GridTICs/gateway-sipia-ciaa/Utilidades/Poncho_EDUCIAA/PonchoKiCad_v1.0/Vistas3D/PonchoGatewayFinal.jpg

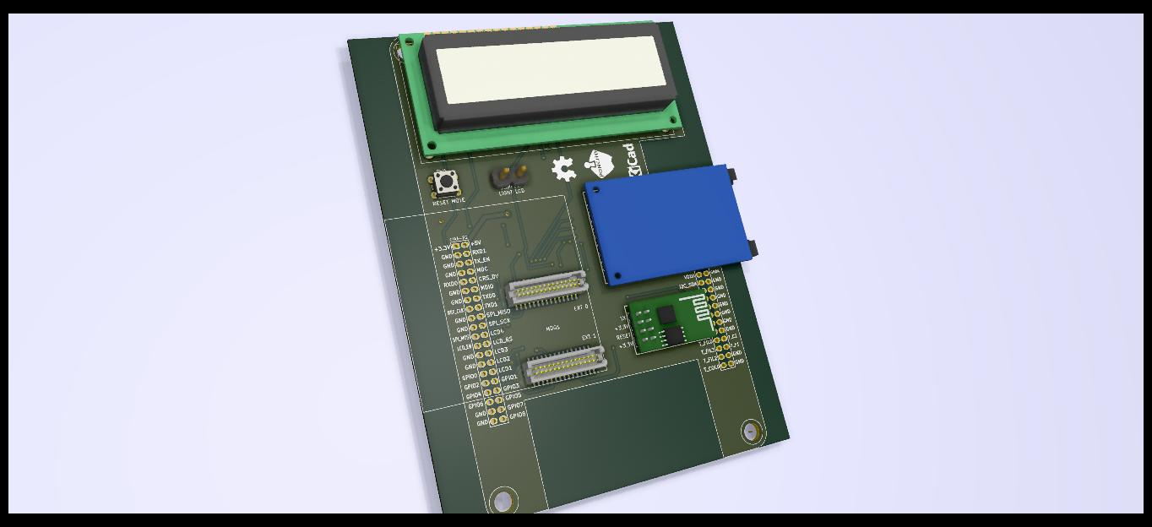
Utilidades/Poncho_EDUCIAA/PonchoKiCad_v1.0/Vistas3D/PonchoGatewayFinal.jpg
