GridTICs/gateway-sipia-ciaa/README.md

# Proyecto Final UTN-FRM - Ingeniería Electrónica

_El proyecto se basa en la creación de un gateway que enlaza una red de sensores con un servidor de internet. El README está en su versión beta._ 🚀

_Estas instrucciones te permitirán obtener una copia del proyecto en funcionamiento en tu CIAA para propósitos de desarrollo y pruebas._

*Todo se ha realizado en base al proyecto EDU-CIAA.*

*Se puede encontrar información correspondiente en su página:*

http://www.proyecto-ciaa.com.ar

### Pre-requisitos 📋

> ```
> Tener instalado el "Embedded IDE", GUI de programación de la EDU-CIAA, creada por Martin Ribelotta - El proyecto está creado en dicha aplicación corriendo en Windows 10 x64.
> ```
>

*Dicho software se puede obtener del siguiente link:*

https://github.com/martinribelotta/embedded-ide-builder/releases/tag/v0.6

*En el mismo ya se encuentran las herramientas necesarias para grabar la EDU-CIAA (NXP en mi caso).*

### Instalación 🔧

_Una serie de ejemplos paso a paso que te dice lo que debes ejecutar para tener un entorno de desarrollo ejecutandose_

_Dí cómo será ese paso_

```
Da un ejemplo
```

_Y repite_

```
hasta finalizar
```

_Finaliza con un ejemplo de cómo obtener datos del sistema o como usarlos para una pequeña demo_-

## Ejecutando las pruebas ⚙️

_Explica como ejecutar las pruebas automatizadas para este sistema_

### Analice las pruebas end-to-end 🔩

_Explica que verifican estas pruebas y por qué_

```
Da un ejemplo
```

### Y las pruebas de estilo de codificación ⌨️

_Explica que verifican estas pruebas y por qué_

```
Da un ejemplo
```

## Deployment 📦

_Agrega notas adicionales sobre como hacer deploy_

## Construido con 🛠️

_[CIAA Embedded IDE](https://github.com/martinribelotta/embedded-ide-builder/releases/tag/v0.6) - El IDE de programación utilizado.

## Contribuyendo 🖇️

Por el momento el proyecto es de carácter privado, pero será abierto cuando la versión beta 1.0 esté finalizada.

## Wiki 📖

Puedes encontrar mucho más de cómo utilizar este proyecto en nuestra [Wiki](https://github.com/tu/proyecto/wiki)

## Autores ✒️

_Menciona a todos aquellos que ayudaron a levantar el proyecto desde sus inicios_

* **Lucas Escribano** - [harrylae](https://github.com/harrylae)
* **Rodrigo Gonzalez** 

## Expresiones de Gratitud 🎁
