GridTICs/gateway-sipia-ciaa/Utilidades/PIN_Outs_Datasheets/ESP8266_Datasheet/ELEC-ESP01S-000.jpg

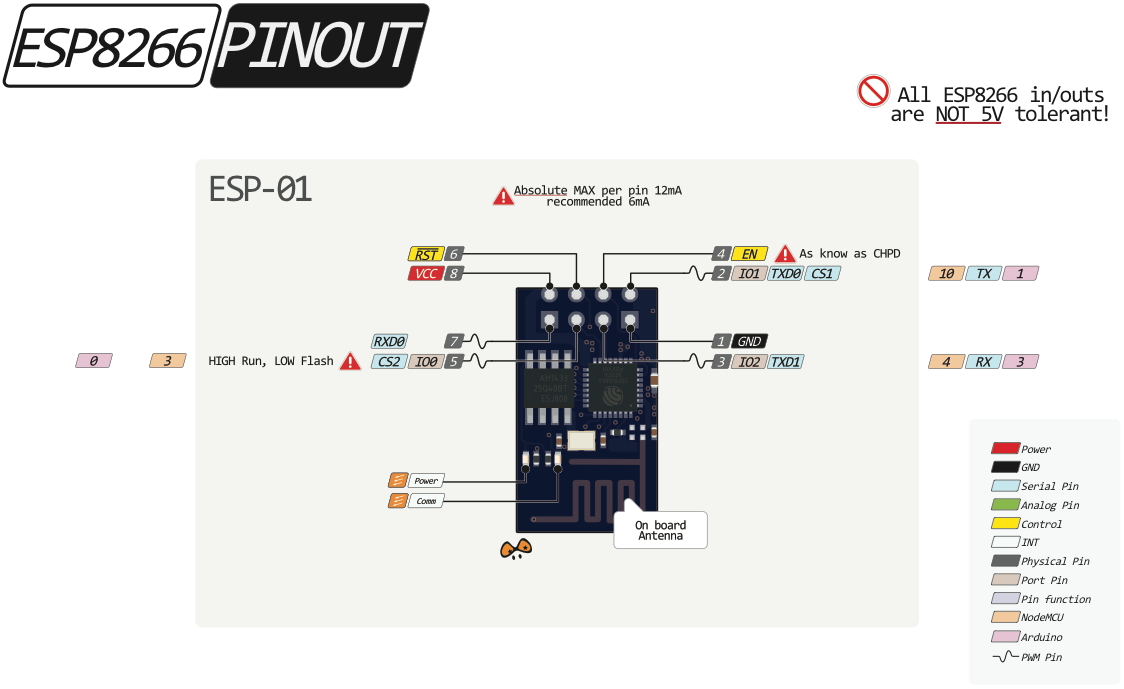
Utilidades/PIN_Outs_Datasheets/ESP8266_Datasheet/ELEC-ESP01S-000.jpg
