GridTICs/gateway-sipia-ciaa/Utilidades/PIN_Outs_Datasheets/SD_Pinout/LC-Studio-SD-Card-Pin-Outs.png

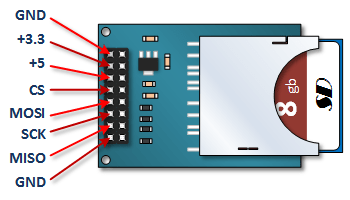
Utilidades/PIN_Outs_Datasheets/SD_Pinout/LC-Studio-SD-Card-Pin-Outs.png
