GridTICs/gateway-sipia-ciaa/Utilidades/Zadig/thumbnail_imagen (1).png

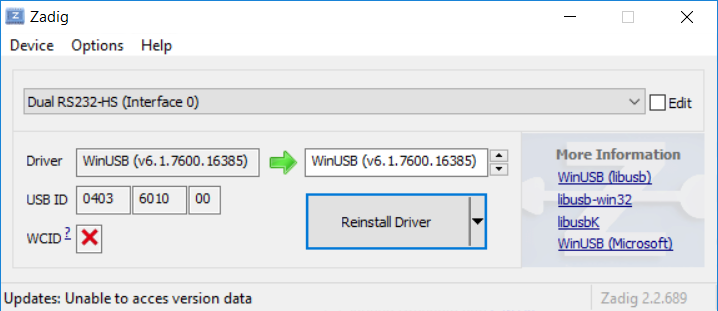
Utilidades/Zadig/thumbnail_imagen (1).png
