GridTICs/gateway-sipia-ciaa/Utilidades/Poncho_EDUCIAA/PonchoKiCad_v1.0/PonchoGateway/3D_Vistas/TFM-115-02-S-D-LC.stp

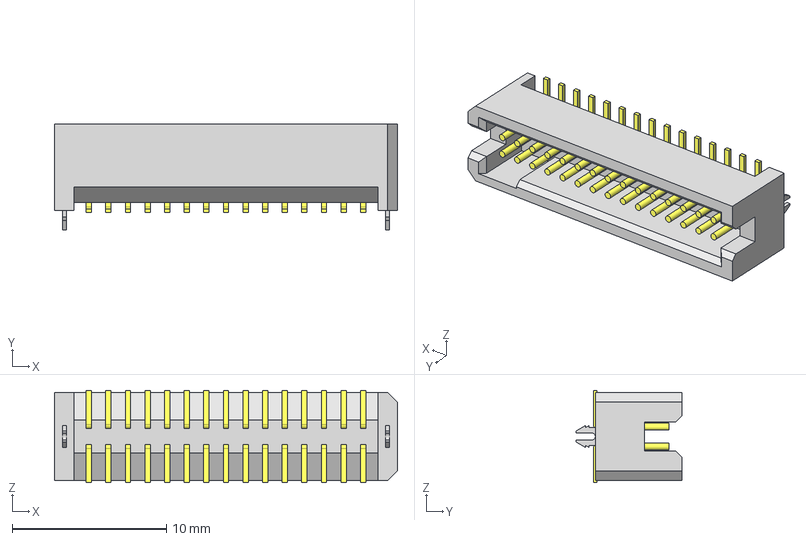
[picture p45: CAD file, 2019-07-15]
Utilidades/Poncho_EDUCIAA/PonchoKiCad_v1.0/PonchoGateway/3D_Vistas/TFM-115-02-S-D-LC.stp
22.2 x 6.86 x 5.97 mm
_TFM-115-02-L-D-LC_terminal
_TFM-115-02-L-D_pins
