GridTICs/gateway-sipia-ciaa/Utilidades/Poncho_EDUCIAA/PonchoKiCad_v1.0/PonchoGateway/3D_Vistas/SD Card Module Arduino.STEP

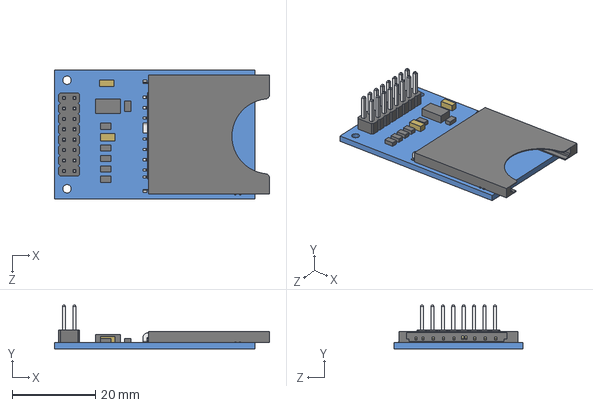
[picture p46: CAD file, 2019-06-25]
Utilidades/Poncho_EDUCIAA/PonchoKiCad_v1.0/PonchoGateway/3D_Vistas/SD Card Module Arduino.STEP
51.5 x 10.5 x 31.0 mm
SD Card Module-part
SD socket
