GridTICs/gateway-sipia-ciaa/Utilidades/Poncho_EDUCIAA/PonchoKiCad_v1.0/PonchoGateway/3D_Vistas/2.54 mm DUPONT MALE PIN HEADER, CONFIGURABLE, 1X2.STEP

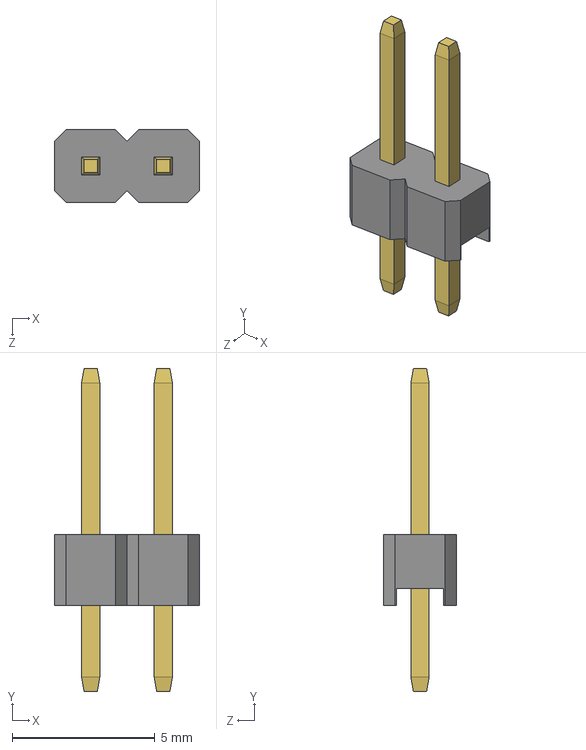
[picture p47: CAD file, 2019-06-25]
Utilidades/Poncho_EDUCIAA/PonchoKiCad_v1.0/PonchoGateway/3D_Vistas/2.54 mm DUPONT MALE PIN HEADER, CONFIGURABLE, 1X2.STEP
5.08 x 11.3 x 2.54 mm
BASE, 2.54 mm DUPONT MALE PIN HEADER, CONFIGURABLE_1X2
PIN, 2.54 mm DUPONT MALE PIN HEADER, CONFIGURABLE x 2
