GridTICs/gateway-sipia-ciaa/(threads)

Thread 1 (2019-07-25):

Eficiencia en la transmisión MOTE -> SERVER

harrylae, 2019-07-25:
La pasarela entre el Mote y el Server no funciona correctamente por debajo de los 5s, lo cual es totalmente inaceptable.

harrylae, 2019-07-27:
El problema fue solucionado, no logro concatenar un Issue con un commit o un push, por eso no cierro el Issue por consola.

Closed 2019-07-27.

Thread 2 (2019-07-25):

Eficiencia transmisión SERVER -> MOTE

harrylae, 2019-07-25:
La transmisión SERVER -> MOTE funciona actualmente bien y sin problemas de tiempos, pero se maneja de una forma poco eficiente, ya que se manda el paquete al mote cada vez que se cumple un timeout luego de recibir una cadena de bytes. Como sabemos la cantidad de datos que recibimos, ya que el ESP8266 nos manda "+IPD,<cantidad de datos>:<datos>" se podría hacer mas eficiente la transmisión de datos sin tiempos, sólo con la cantidad de datos.

harrylae, 2019-07-27:
Logré solucionar el problema. Cada vez que llega un paquete con el prefijo "+IPD," la interrupción trabaja dicho paquete y manda automáticamente su contenido al UART del MOTE. (UART_GPIO).

Closed 2019-07-27.

Thread 3 (2019-07-25):

Guardado en SD como buffer de respaldo

harrylae, 2019-07-25:
La EDU-CIAA guarda el contenido del buffer de recepción desde el MOTE en la SD cada vez que no puede establecer una conexión con el SERVER. Se debe hacer esto más eficiente. Se podría guardar los datos en un buffer mas grande, para luego una vez que tengo una cantidad de datos establecido mandarlos hacia la SD.

anadiedrichs, 2019-08-01:
buenas, ¿cómo va? ¿guarda o no los datos en la SD?

harrylae, 2019-08-01:
Si, pero estoy arreglando esa parte para que sea más rápida. Estoy camino a mi casa, para esta noche cierro el issue. Esta noche a altas horas probablemente 🙌

Thread 4 (2019-07-25):

Menu en Consola Serie para guardar Parámetros

harrylae, 2019-07-25:
Hoy los datos de las conexiones se encuentran y se sustraen desde la SD al momento del arranque. Hay que realizar un menu de configuración, de forma que pueda establecer los datos sin tener que sacar la SD de la EDU-CIAA.

Closed 2019-07-28.

Thread 6 (2019-07-27):

Mostrar por Pantalla LCD mensajes de lo que ocurre en todo momento.

harrylae, 2019-07-27:
Si nosotros apretamos uno de los botones de la EDU-CIAA automáticamente por pantalla debo mostrar mensajes orientativos de lo que sucede en todo momento. La idea es haces esto con interrupciones de clock para que no afecte el comportamiento de las otras funcionalidades del Gateway.
