GridTICs/gateway-sipia-ciaa/Utilidades/Poncho_EDUCIAA/ParteMote/ProyectoFinal.PDF

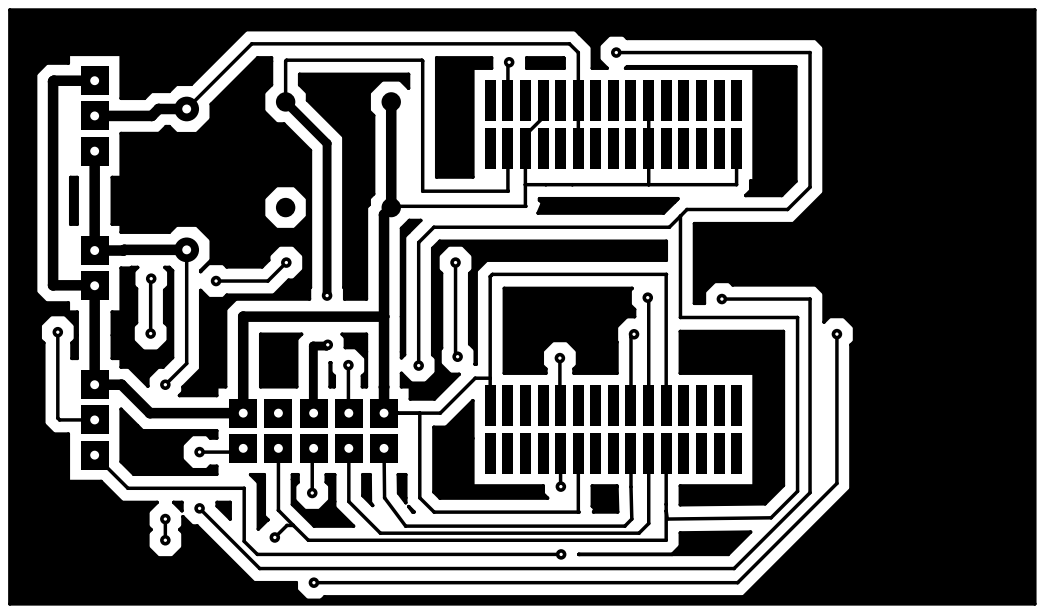
[picture p50: page 1]
