GridTICs/gateway-sipia-ciaa/Utilidades/Poncho_EDUCIAA/PonchoKiCad_v1.0/Board/MascaraSoldarDelantera.pdf

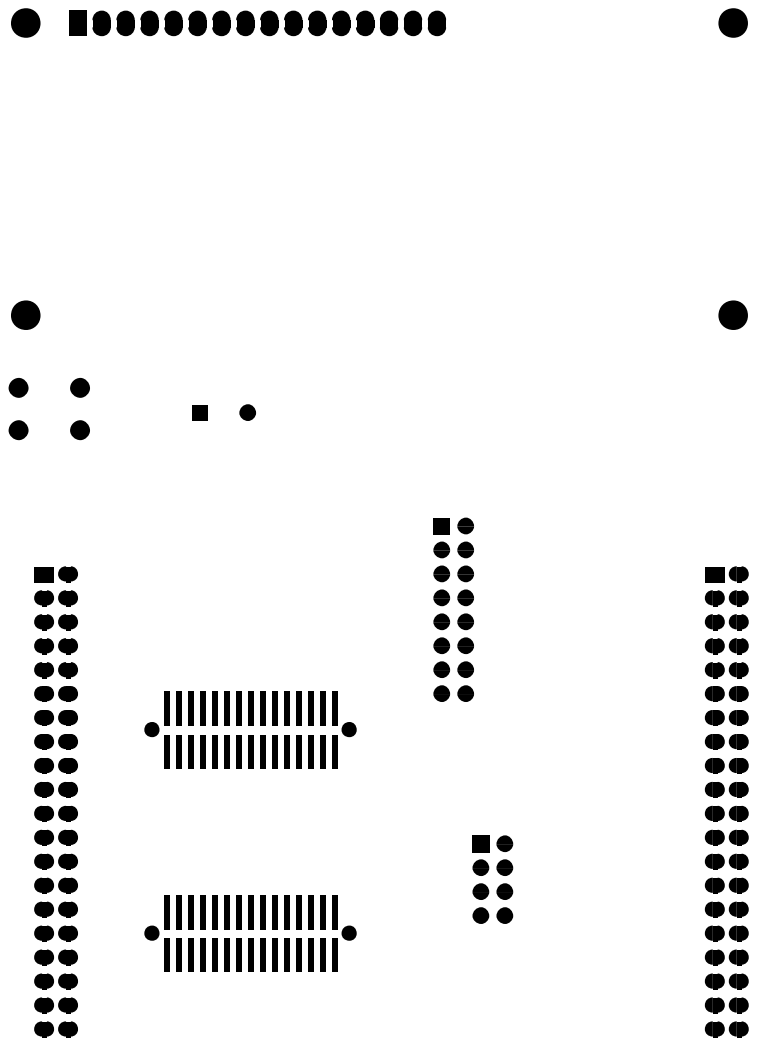
[picture p51: page 1]
