GridTICs/gateway-sipia-ciaa/Utilidades/Poncho_EDUCIAA/PonchoKiCad_v1.0/Board/MascaraSoldarTrasera.pdf

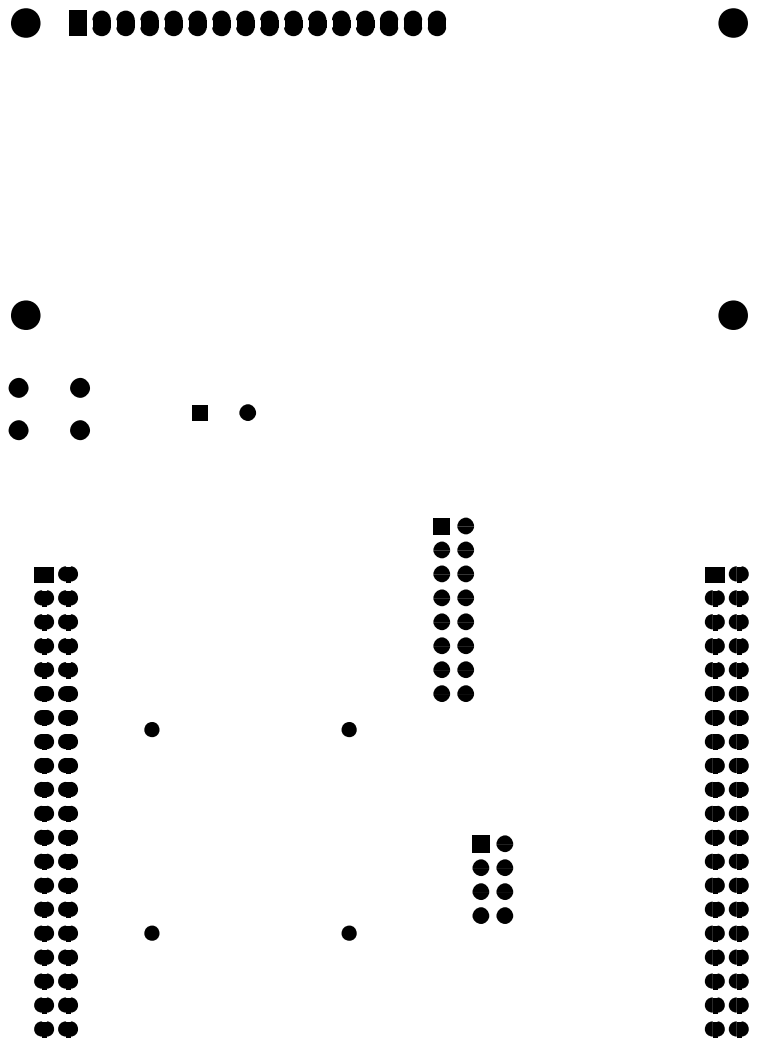
[picture p52: page 1]
