GridTICs/gateway-sipia-ciaa/Utilidades/Poncho_EDUCIAA/PonchoKiCad_v1.0/Board/SerigrafíaDelantera.pdf

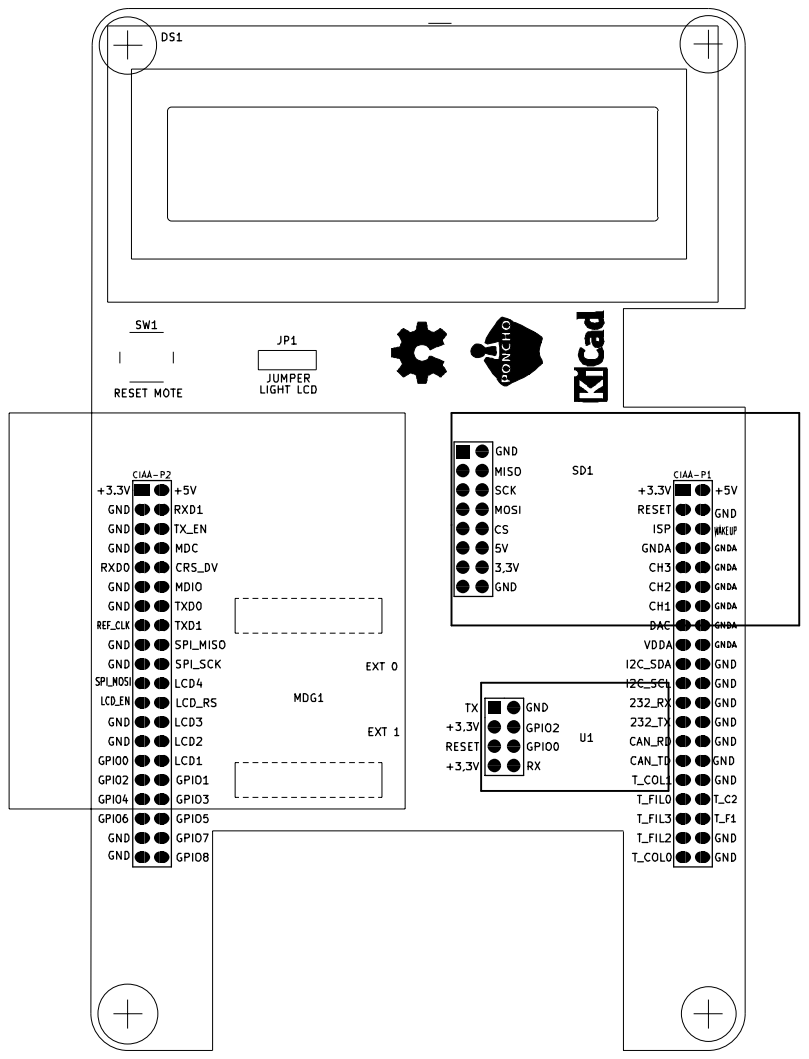
[picture p53: page 1]
