GridTICs/gateway-sipia-ciaa/Utilidades/Poncho_EDUCIAA/PonchoKiCad_v1.0/Board/SerigrafíaTrasera.pdf

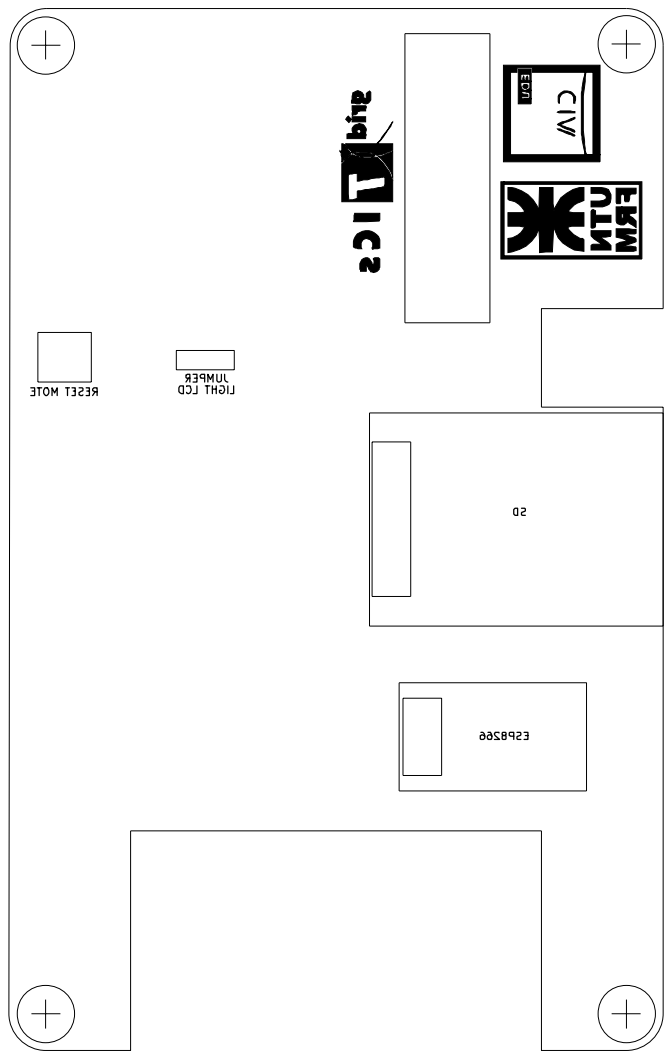
[picture p54: page 1]
