GridTICs/gateway-sipia-ciaa/Utilidades/Poncho_EDUCIAA/PonchoKiCad_v1.0/Board/VistaDelantera.pdf

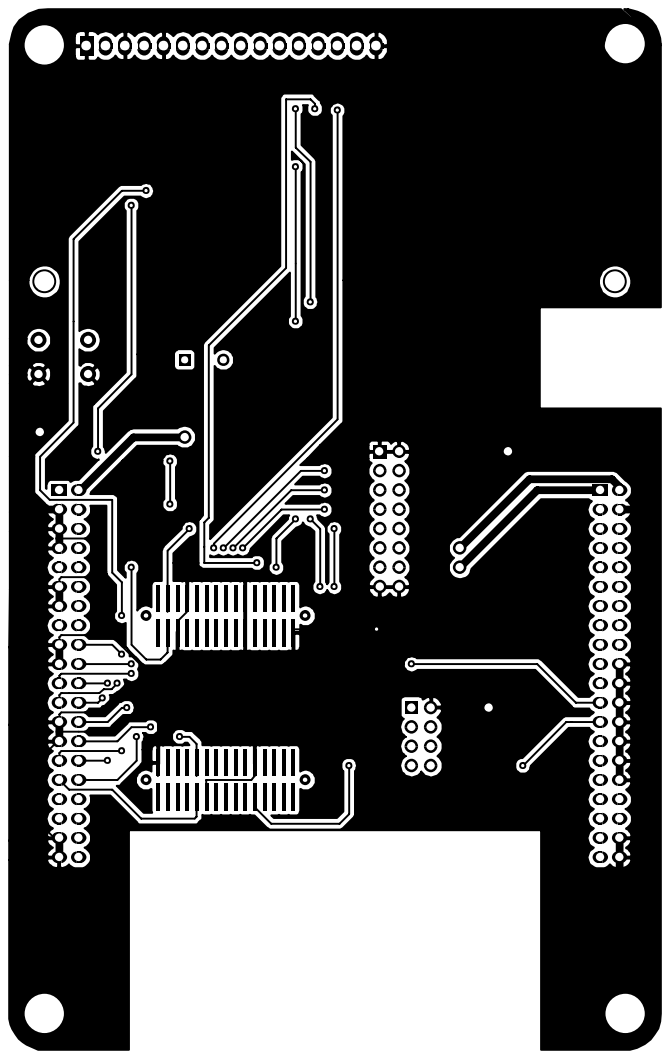
[picture p55: page 1]
