GridTICs/gateway-sipia-ciaa/Utilidades/Poncho_EDUCIAA/PonchoKiCad_v1.0/Board/VistaTrasera.pdf

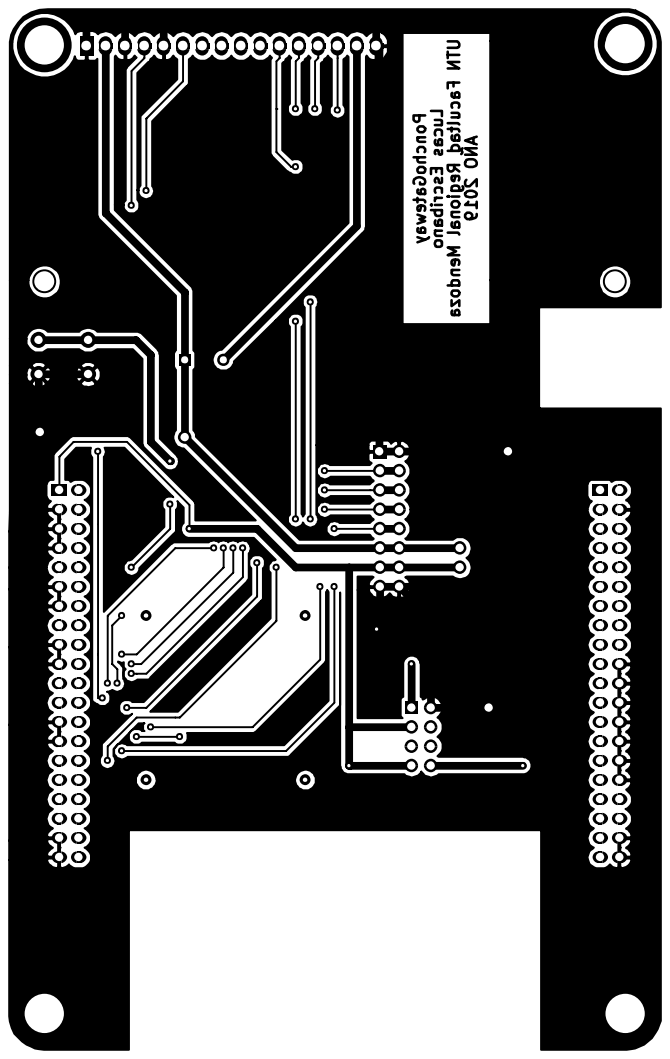
[picture p56: page 1]
