GridTICs/gateway-sipia-ciaa/(list of files, drawings)

Other design files:
Utilidades/Poncho_EDUCIAA/ParteMote/ProyectoFinal.pdsprj
Utilidades/Poncho_EDUCIAA/PlacaFinalProteus_v1.0/ProyectoFina_EDUCIAA.pdsprj
