GridTICs/gateway-sipia-ciaa/Utilidades/Poncho_EDUCIAA/PonchoKiCad_v1.0/PonchoGateway/PonchoGateway.kicad_pcb

## KiCad design Utilidades/Poncho_EDUCIAA/PonchoKiCad_v1.0/PonchoGateway/PonchoGateway.kicad_pcb (2019-07-15)

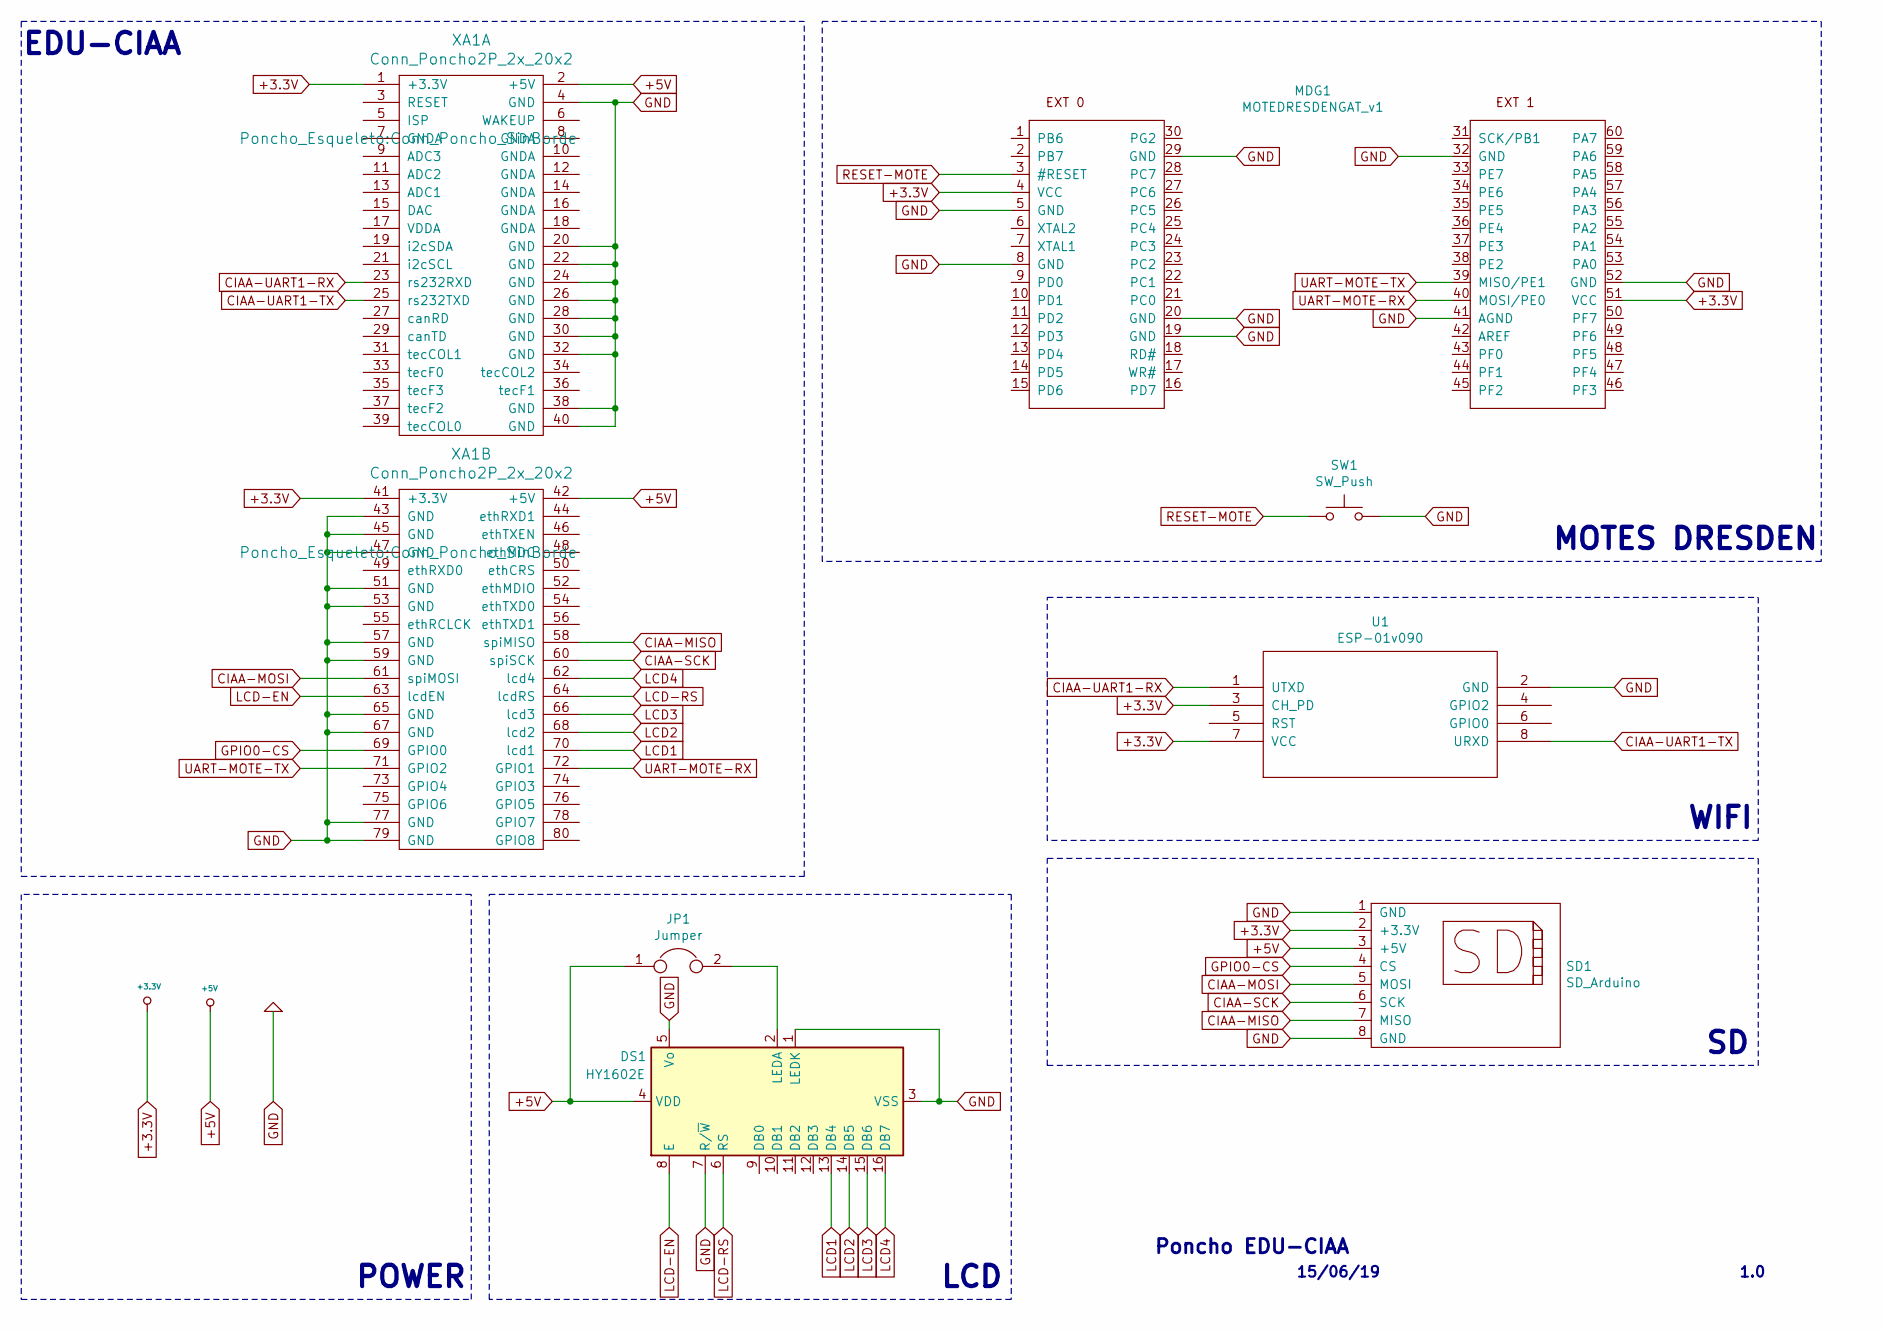
[picture p57: schematic PonchoGateway.sch]

Parts:
DS1: HY1602E; Display_Propio
JP1: Jumper; JUMPER-PONCHO-EDU-CIAA
MDG1: MOTEDRESDENGAT_v1; SAMTEC-EDU-CIAA
SD1: SD_Arduino; SD-SHIELD-ARD
SW1: SW_Push; SW_PUSH_6mm
U1: ESP-01v090; ESP-01
XA1: Conn_Poncho2P_2x_20x2; Conn_Poncho_SinBorde

Connections:
+3.3V: MDG1.4 (VCC), MDG1.51 (VCC), SD1.2 (+3.3V), U1.3 (CH_PD), U1.7 (VCC), XA1.1 (+3.3V), XA1.41 (+3.3V)
+5V: DS1.4 (VDD), JP1.1, SD1.3 (+5V), XA1.2 (+5V), XA1.42 (+5V)
CIAA-MISO: SD1.7 (MISO), XA1.58 (spiMISO)
CIAA-MOSI: SD1.5 (MOSI), XA1.61 (spiMOSI)
CIAA-SCK: SD1.6 (SCK), XA1.60 (spiSCK)
CIAA-UART1-RX: U1.1 (UTXD), XA1.23 (rs232RXD)
CIAA-UART1-TX: U1.8 (URXD), XA1.25 (rs232TXD)
GND: DS1.1 (LEDK), DS1.3 (VSS), DS1.5 (Vo), DS1.7 (R/~W), MDG1.5 (GND), MDG1.8 (GND), MDG1.19 (GND), MDG1.20 (GND), MDG1.29 (GND), MDG1.32 (GND), MDG1.41 (AGND), MDG1.52 (GND), SD1.1 (GND), SD1.8 (GND), SW1.2, U1.2 (GND), XA1.4 (GND), XA1.20 (GND), XA1.22 (GND), XA1.24 (GND), XA1.26 (GND), XA1.28 (GND), XA1.30 (GND), XA1.32 (GND), XA1.38 (GND), XA1.40 (GND), XA1.43 (GND), XA1.45 (GND), XA1.47 (GND), XA1.51 (GND), XA1.53 (GND), XA1.57 (GND), XA1.59 (GND), XA1.65 (GND), XA1.67 (GND), XA1.77 (GND), XA1.79 (GND)
GPIO0-CS: SD1.4 (CS), XA1.69 (GPIO0)
LCD1: DS1.13 (DB4), XA1.70 (lcd1)
LCD2: DS1.14 (DB5), XA1.68 (lcd2)
LCD3: DS1.15 (DB6), XA1.66 (lcd3)
LCD4: DS1.16 (DB7), XA1.62 (lcd4)
LCD-EN: DS1.8 (E), XA1.63 (lcdEN)
LCD-RS: DS1.6 (RS), XA1.64 (lcdRS)
unnamed: DS1.2 (LEDA), JP1.2
RESET-MOTE: MDG1.3 (#RESET), SW1.1
UART-MOTE-RX: MDG1.40 (MOSI/PE0), XA1.72 (GPIO1)
UART-MOTE-TX: MDG1.39 (MISO/PE1), XA1.71 (GPIO2)

Notes on the sheet:
MOTES DRESDEN
WIFI
LCD
POWER
EDU-CIAA
Poncho EDU-CIAA
1.0
15/06/19

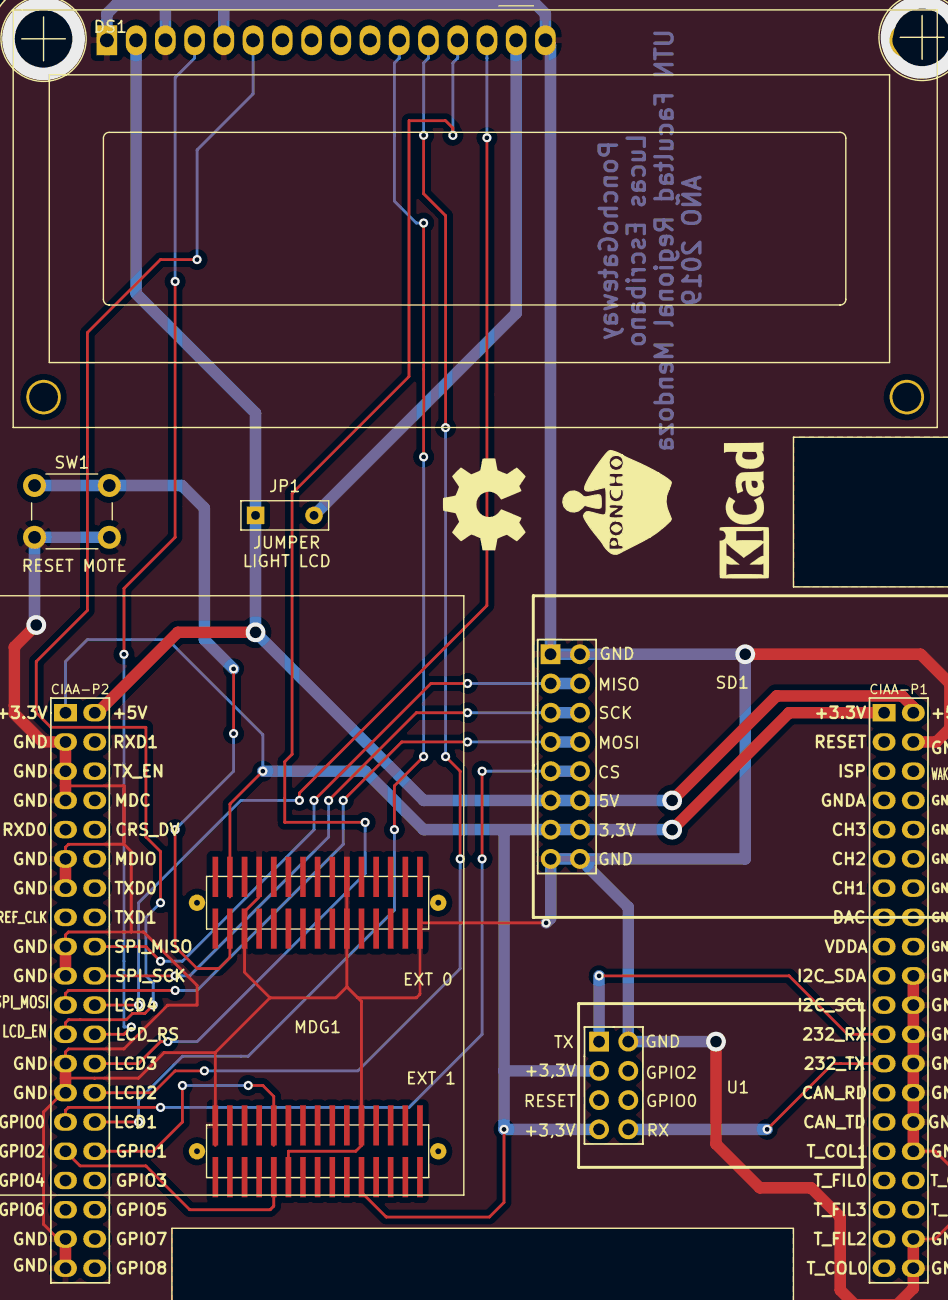
[picture p58: board PonchoGateway.kicad_pcb from above]

Board: 2 copper layers, 8 parts (0 on the bottom side), 19 nets.

Other parts of the board:
G101: Logo_OSHWA
