GridTICs/gateway-sipia-ciaa/Project_Gateway/inc/MandarDatos.h

//************************************************************************************************************************************************************************************************
//
//Esta función manda los recibido por Uart a la conexión TCP/IP del ESP8266, si esto no es posible guarda los datos en una SD.
// - No recibe ningún valor
//
//************************************************************************************************************************************************************************************************
enum {
  
    SD_NO_DATA = 0,
    SD_WITH_DATA,
    SD_ERROR,  
   
};

uint8_t statusSD;

//Se crea un buffer global de 100 * 100 datos 10KB
uint8_t bufferGlobalSD[100][100];


void Mandar_Uart_TCP()
{
    
    uint8_t bufferSD[UART_MOTE_RX_BUFF_SIZE];
    uint8_t bufferGpioRX_Aux[UART_MOTE_RX_BUFF_SIZE];
    uint16_t dataSizeSD;
    uint8_t *ptrBuffSD;
    
    
    switch(statusSD)
    {
     case   SD_NO_DATA:
     
        gpioWrite( LEDB, OFF );
        gpioWrite( LEDG, ON );
        gpioWrite( LED1, OFF );
        lcdStatus = EST_OK;
        
        if(espSendDataServer())uartWriteString(UART_USB, "SEND_OK");
        else 
        {
            uartWriteString(UART_USB, "NO SEND");
            if(fatFsWriteText("BUFF.TXT", gpioRxBuffer))statusSD = SD_WITH_DATA;        
            else statusSD = SD_ERROR;
        }
        
     break;    
     
     case  SD_WITH_DATA:
        
        gpioWrite( LEDB, OFF );
        gpioWrite( LEDG, OFF );
        gpioWrite( LED1, ON );
        lcdStatus = GUARDA_SD;
     
        ptrBuffSD = bufferSD;
        dataSizeSD = fatFs_Open_and_GetSize("BUFF.TXT", bufferSD);
        Erase_Arch("BUFF.TXT");
    
        if(dataSizeSD > 0 )
        {
            //Seteamos el puntero donde dejamos de escribir datos desde la SD:
            ptrBuffSD = ptrBuffSD + dataSizeSD;
            
            //Copiamos el buffer de recepción del Gpio al buffer auxiliar
            //La cantidad es la encontrada en la interrrupción + los dos primeros bytes
            memcpy(ptrBuffSD, gpioRxBuffer, cantDatos+2);
            memset(gpioRxBuffer,'\0',sizeof(gpioRxBuffer));
            memcpy(gpioRxBuffer,ptrBuffSD, dataSizeSD + cantDatos + 2);
            uartWriteString(UART_USB, "Los datos que se mandan son: ");
            uartWriteByteArray(UART_USB,gpioRxBuffer,dataSizeSD + cantDatos + 2);
            
            if(espSendDataServer())
            {
                uartWriteString(UART_USB, "SE ENVIO DESPUES DE RECUPERAR EL BUFFER");
                statusSD = SD_NO_DATA;
            }
            else
            {
                uartWriteString(UART_USB, "NO SE MANDA ESTA VEZ");
                if(fatFsWriteText("BUFF.TXT",gpioRxBuffer))statusSD = SD_WITH_DATA; 
                else statusSD = SD_ERROR;
            } 
            
        }
        else
        {
            statusSD = SD_ERROR;
        }    
            
     break;  
  
     case SD_ERROR:
        LCD_Estado(EST_ERROR); 
        stopProgramError(); // Como dio falso (error) me quedo en un bucle infinito
     break;
     
    }
    
    
    ResetGpioBuff();
}

//************************************************************************************************************************************************************************************************
//
//Esta función manda los recibido por TCP/IP al Uart del Gpio
// - No recibe ningún valor
// - Utiliza todas variables globales:
//        1 - bandera_dato_esp  es la bandera que nos indica que ha llegado un dato por TCP/IP
//        2 - time_rx_esp_set   cada vez que llega un nuevo dato se lee el tickRead() y se guarda en esta variable
//        3 - timeout_rx_esp    es un tiempo fijo, si el tiempo entre el último dato recibido (time_rx_esp_set) y el actual es mayor a timeout_rx_esp es condición para mandar el paquete
//        4 - espRxIntBuffer    es el buffer de recepción del ESP8266
//        5 - punt_rx_esp       es la cantidad de datos que han llegado, cada vez que llega un dato se incrementa esta variable
//
//************************************************************************************************************************************************************************************************

void Mandar_Uart_Gpio()
{
 
    uint32_t cantDataIn = 0;
        /*
    
        if(bandera_dato_esp == true && tickRead() - time_rx_esp_set > timeout_rx_esp) //&& bandera_dato_gpio == false)
        {
            
            cantDataIn = espCleanReceivedData(espRxIntBuffer);
            
            uartWriteString(UART_USB, "\r\nLa cantidad de datos en Buffer es: ");
            uartWriteString(UART_USB,intToString(cantDataIn));
            
            if(cantDataIn > 0)
            {
                uartWriteString(UART_USB, "\r\nEl buffer ha sido limpiado correctamente.\r\n");
            }    
            else
            {
                uartWriteString(UART_USB, "\r\nEl buffer NO ha sido limpiado correctamente.\r\n");
            }    
            uartWriteString(UART_USB, "\r\nEl dato que he recibido es: ");
            uartWriteByteArray(UART_USB, espRxIntBuffer, cantDataIn);
            uartWriteByteArray(UART_GPIO, espRxIntBuffer,cantDataIn);
            memset( espRxIntBuffer, '\0', sizeof(espRxIntBuffer) );
            bandera_dato_esp = false;
            //Reinicializamos nuevamente el puntero del buffer para que apunte a la primer dirección del mismo
            punt_rx_esp=espRxIntBuffer; 
            
        }  */
    
}
