GridTICs/gateway-sipia-ciaa/(commit log)

2019-03-17 First Commit by Lucas Escribano
    [Faltantes.xlsx, Project_Gateway.names.csv, ProyectoFina_EDUCIAA.pdsprj, iot_thingspeak.names.csv, lpc4337.cfg, rx_interrupt.names.csv, tx_rx_interrupt_bridge.names.csv]
2019-03-17 Probando Configuraciones de Proyecto Avanzadas
2019-03-17 Actualizando lista de Pendientes...
    [Faltantes.xlsx]
2019-03-17 Subiendo cambios para cambiar de PC.
    [Project_Gateway.names.csv]
2019-03-23 Subiendo cambios en cosas_faltantes.xml
    [Faltantes.xlsx]
2019-03-24 Cambios en la organización de las carpetas, se agrega el driver FTDI, el programa de SERIAL, se logra la bidireccionalidad.
    [Faltantes.xlsx, Project_Gateway.names.csv, ProyectoFina_EDUCIAA.pdsprj]
2019-04-02 Se arregla problema del servidor NTP, la hora se carga correctamente, se deja menues listos en LCD para seguir trabajandoen ellos.
    [Faltantes.xlsx, Project_Gateway.names.csv, ProyectoFina_EDUCIAA.pdsprj]
2019-05-22 Subo el informe del proyecto final de la carrera. Falta terminar.
2019-05-22 Subo un Modelo BETA del Readme.md para comenzar a trabajar con el mismo.
2019-05-22 Probando con el Readme.md
2019-05-22 Pude comentar lo que no se debe mostrar. Sigo evaluando el uso de Readme.md
2019-05-27 Agregando la visibilidad de ESTADOS en el LCD.
    [Project_Gateway.names.csv]
2019-05-28 Se agregan los estados iniciales en el LCD, por lo tanto no hace falta estar conectado el puerto serie para saber lo que está sucediendo.
    [Project_Gateway.names.csv]
2019-05-28 Se agrega señalización de Estados con los LED RGB (Gpio) de la EDU-CIAA.
    [Project_Gateway.names.csv]
2019-05-29 Se realizan cambios en la forma de conexión del ESP para que o se produzcan errores al iniciarlo. Se agrega el Datasheet para utilizarlo si es necesario.
    [Project_Gateway.names.csv]
2019-06-07 Se actualizan las cosas faltantes. Se verifica la placa Poncho EDUCIAA.
    [Faltantes.xlsx]
2019-06-09 Se comienza el desarrollo del PONCHO hardware de la EDU-CIAA Gateway, reemplazando el modelo en Proteus por Kicad.
    [PonchoGateway.kicad_pcb, PonchoGateway.sch, ProyectoFina_EDUCIAA.pdsprj, ProyectoFinal.pdsprj]
2019-06-12 Trabajando en el .sch del Poncho Gateway de la EDU-CIAA.
    [PonchoGateway.kicad_pcb, PonchoGateway.sch, ProyectoFina_EDUCIAA.pdsprj]
2019-06-16 Arreglo PonchoGateway, corrijo huellas y ubico componentes en la placa final.
    [PonchoGateway.kicad_pcb, PonchoGateway.sch]
2019-06-17 Subo esquemático del ESP8266, y se modifica el PCB de poncho EDU-CIAA-Gateway.
    [PonchoGateway.kicad_pcb]
2019-06-18 Se corrige error en esquemático, y se termina el pcb.
    [PonchoGateway.kicad_pcb, PonchoGateway.sch]
2019-06-21 Se agregan Logos en el PonchoGateway, al igual que los power plane referidos a GND en ambas caras.
    [PonchoGateway.kicad_pcb]
2019-06-21 Se corrigen problemas en el SCH y PCB. Se realiza última comprobación antes de hacer la placa.
    [PonchoGateway.kicad_pcb, PonchoGateway.sch]
2019-06-21 Imprimo las distintas capas para realizar el PCB.
    [PonchoGateway.kicad_pcb]
2019-06-22 Agrego modelo 3D del esp8266, y organizo archivos correctamente.
    [PonchoGateway.kicad_pcb]
2019-06-22 Agrego imágenes de vistas 3D para informe.
2019-06-23 Modifico el informe final, agrego contenido, creo referencias, evaluación económica, etc.
2019-06-25 Actualizo vistas 3D de componentes SD y Jumper.
    [2.54 mm DUPONT MALE PIN HEADER, CONFIGURABLE, 1X2.STEP, 2.54 mm DUPONT MALE PIN HEADER, CONFIGURABLE, 1X2.x_b, PonchoGateway.kicad_pcb, SD Card Module Arduino.STEP]
2019-07-15 Probando la Placa -PonchoGateway-, funciona todo correctamente. Hay que mejorar el software a futuro.
    [2.54 mm DUPONT MALE PIN HEADER, CONFIGURABLE, 1X2.x_b, PonchoGateway.kicad_pcb, TFM-115-02-S-D-LC.stp, rx_interrupt.names.csv]
2019-07-17 Ordenando el Repositorio
2019-07-17 Trabajando en el README.md
2019-07-20 Volviendo cambios.
    [Project_Gateway.names.csv]
2019-07-20 No recibo mas los datos del NTP por interrupción, sino por funciones propias del UART. - NO FUNCIONA -
    [Project_Gateway.names.csv]
2019-07-23 Queda solucionado el problema de servidor NTP.
    [Project_Gateway.names.csv]
2019-07-24 Agrego la actualización del informe del proyecto final.
2019-07-24 Se arregla la pasarela Server->Coordinador
    [Project_Gateway.names.csv]
2019-07-24 No se arregla el problema con la llegada de datos por UART y el posterior envío al server.
    [Project_Gateway.names.csv]
2019-07-24 Se empieza con el Menu por Consola Serie.
2019-07-25 Observamos los datos que llegan desde el Mote, encontramos que el baud rate es de 9600.
    [Project_Gateway.names.csv]
2019-07-25 Se crea una máquina de estados para recibir los datos en el UART, se prueban los ISSUES
    [Project_Gateway.names.csv]
2019-07-25 Creo interrupción del TIMER_0 para leer los estados de la conexión del SERVER.
    [Project_Gateway.names.csv]
2019-07-26 Realicé la función de envío mucho mas esficiente, al igual que la de la recepción.
    [Project_Gateway.names.csv]
2019-07-26 Avanzo con el informe final. Agrego la parte del proyecto de GridTics
2019-07-27 Cambios en el Informe Final.
2019-07-27 Solucionando los problemas de comunicación bidireccional.
    [Project_Gateway.names.csv]
2019-07-27 Trabajando en el Issue #5
2019-07-27 Trabajando en el Issue #6
    [Project_Gateway.names.csv]
2019-07-27 Trabajando en el Menu de Configuración. Issue #4
    [Project_Gateway.names.csv]
2019-07-27 Armando menu, menu parametros WiFi terminado. Issue #4
    [Project_Gateway.names.csv]
2019-07-28 Terminado el menu en consola serie para la configuración de parámetros. Fixes #4
    [Project_Gateway.names.csv]
2019-07-29 Trabajando en el Informe. Issue #8
    [Project_Gateway.names.csv]
2019-07-30 Termino el infrome final. Creo PDF para imprimir. Fixes #8
    [ESP8266_driver.h, EstadosLCD.h, MandarDatos.h, Project_Gateway.c]
2019-08-01 Trabajando en el Issue #3. Muchos errores y no cree branch :-(
    [Project_Gateway.names.csv]
2019-08-02 Terminando la presentación y solucionando lo de la SD.
    [CONFIG.TXT, Project_Gateway.names.csv]
